g2maurer/MPPT1KW/README.md

# MPPT1KW
 Solar Battery Charger
   1. 4/18/2023 Added PCB files (KiCad).
   2. 10/11/2023 Updated BOM files:
      MPPT_1KW_ESP32_ggmV3.xlsx
      MPPT V3 BOM.pdf
   4. 04/23/2024 Added new enclosure design (new design was done with FreeCAD).
      The dimensions have not changed but the new design incorporates the fan and vent grills.
