g2maurer/MPPT1KW/Enclosure/FreeCAD/MPPT Cover.FCStd

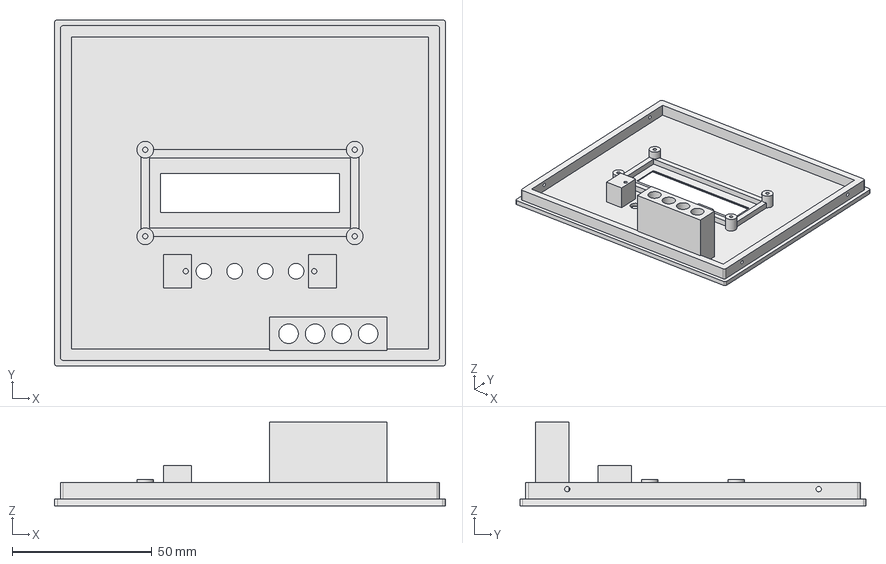
[picture p1: CAD file, 2024-04-24]
Enclosure/FreeCAD/MPPT Cover.FCStd
140.0 x 124.0 x 30.0 mm
