g2maurer/MPPT1KW/Enclosure/TinkerCAD/Back_Grill_V2.stl

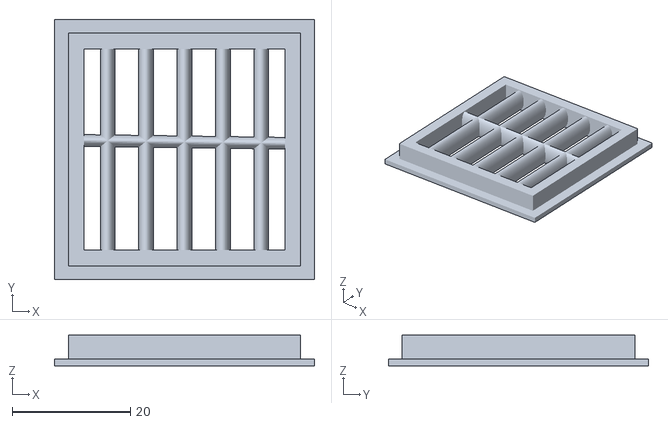
[picture p2: CAD file, 2024-04-18]
Enclosure/TinkerCAD/Back_Grill_V2.stl
44.0 x 44.0 x 5.20
