g2maurer/MPPT1KW/Enclosure/FreeCAD/MPPT_Button.FCStd

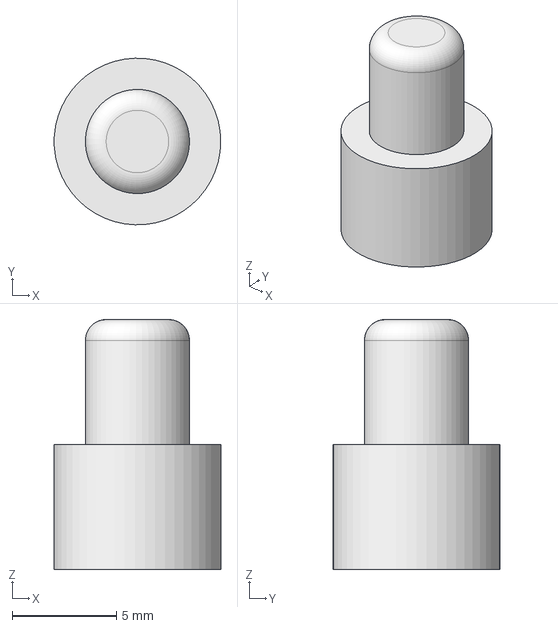
[picture p3: CAD file, 2024-04-24]
Enclosure/FreeCAD/MPPT_Button.FCStd
7.99 x 8.00 x 12.0 mm
