g2maurer/MPPT1KW/Enclosure/TinkerCAD/MPPT_g2m_V3.1.stl

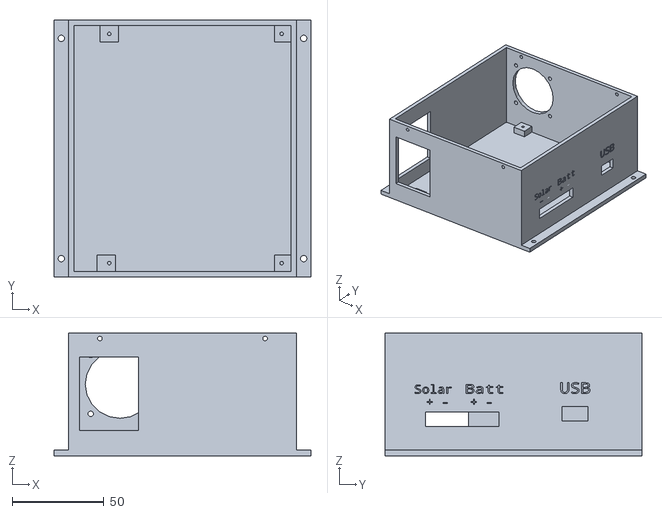
[picture p4: CAD file, 2024-04-18]
Enclosure/TinkerCAD/MPPT_g2m_V3.1.stl
140.0 x 140.0 x 67.0
