g2maurer/MPPT1KW/Enclosure/FreeCAD/MPPT Enclosure.stl

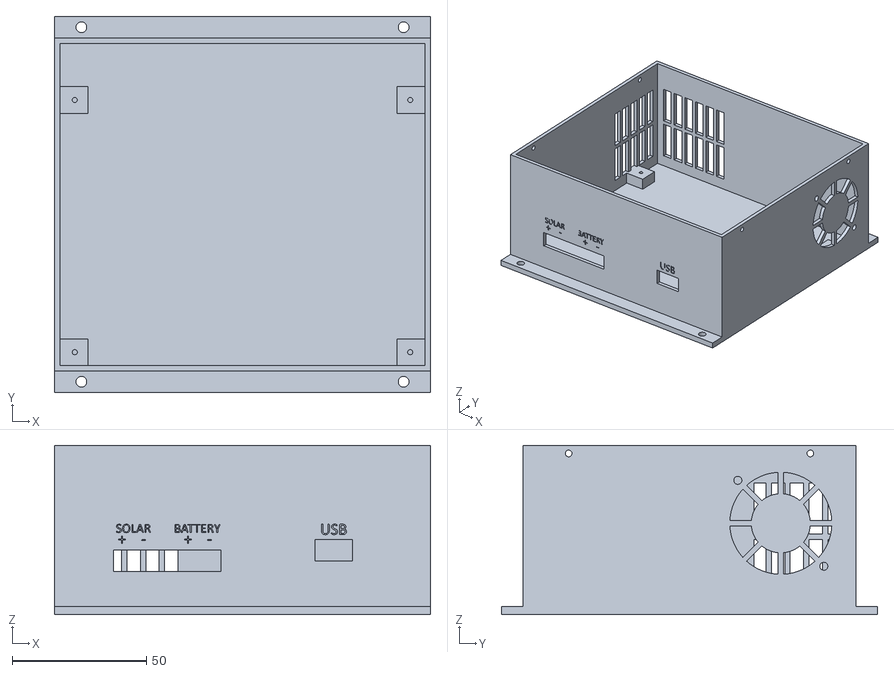
[picture p5: CAD file, 2024-04-23]
Enclosure/FreeCAD/MPPT Enclosure.stl
140.0 x 140.0 x 63.0
