g2maurer/MPPT1KW/Enclosure/TinkerCAD/Side_Grill_V2.stl

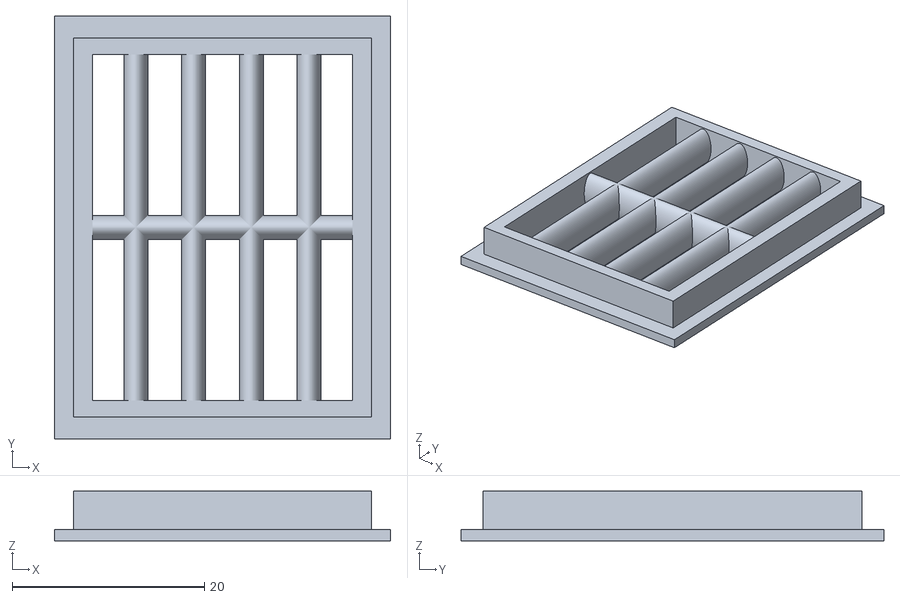
[picture p6: CAD file, 2024-04-18]
Enclosure/TinkerCAD/Side_Grill_V2.stl
35.0 x 44.0 x 5.20
