g2maurer/MPPT1KW/Enclosure/TinkerCAD/Fan Cover 40mm.stl

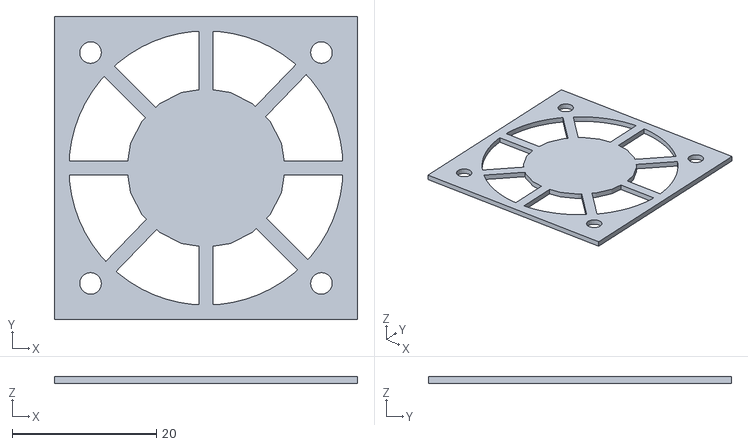
[picture p7: CAD file, 2024-04-18]
Enclosure/TinkerCAD/Fan Cover 40mm.stl
42.0 x 42.0 x 1.00
