g2maurer/MPPT1KW/(list of files, cad)

Other CAD files:
Enclosure/FreeCAD/MPPT Button.stl
Enclosure/FreeCAD/MPPT Cover.stl
