g2maurer/MPPT1KW/PCB/MPPT_1KW_ESP32_ggmV3.kicad_pcb

## KiCad design PCB/MPPT_1KW_ESP32_ggmV3.kicad_pcb (2023-04-18)

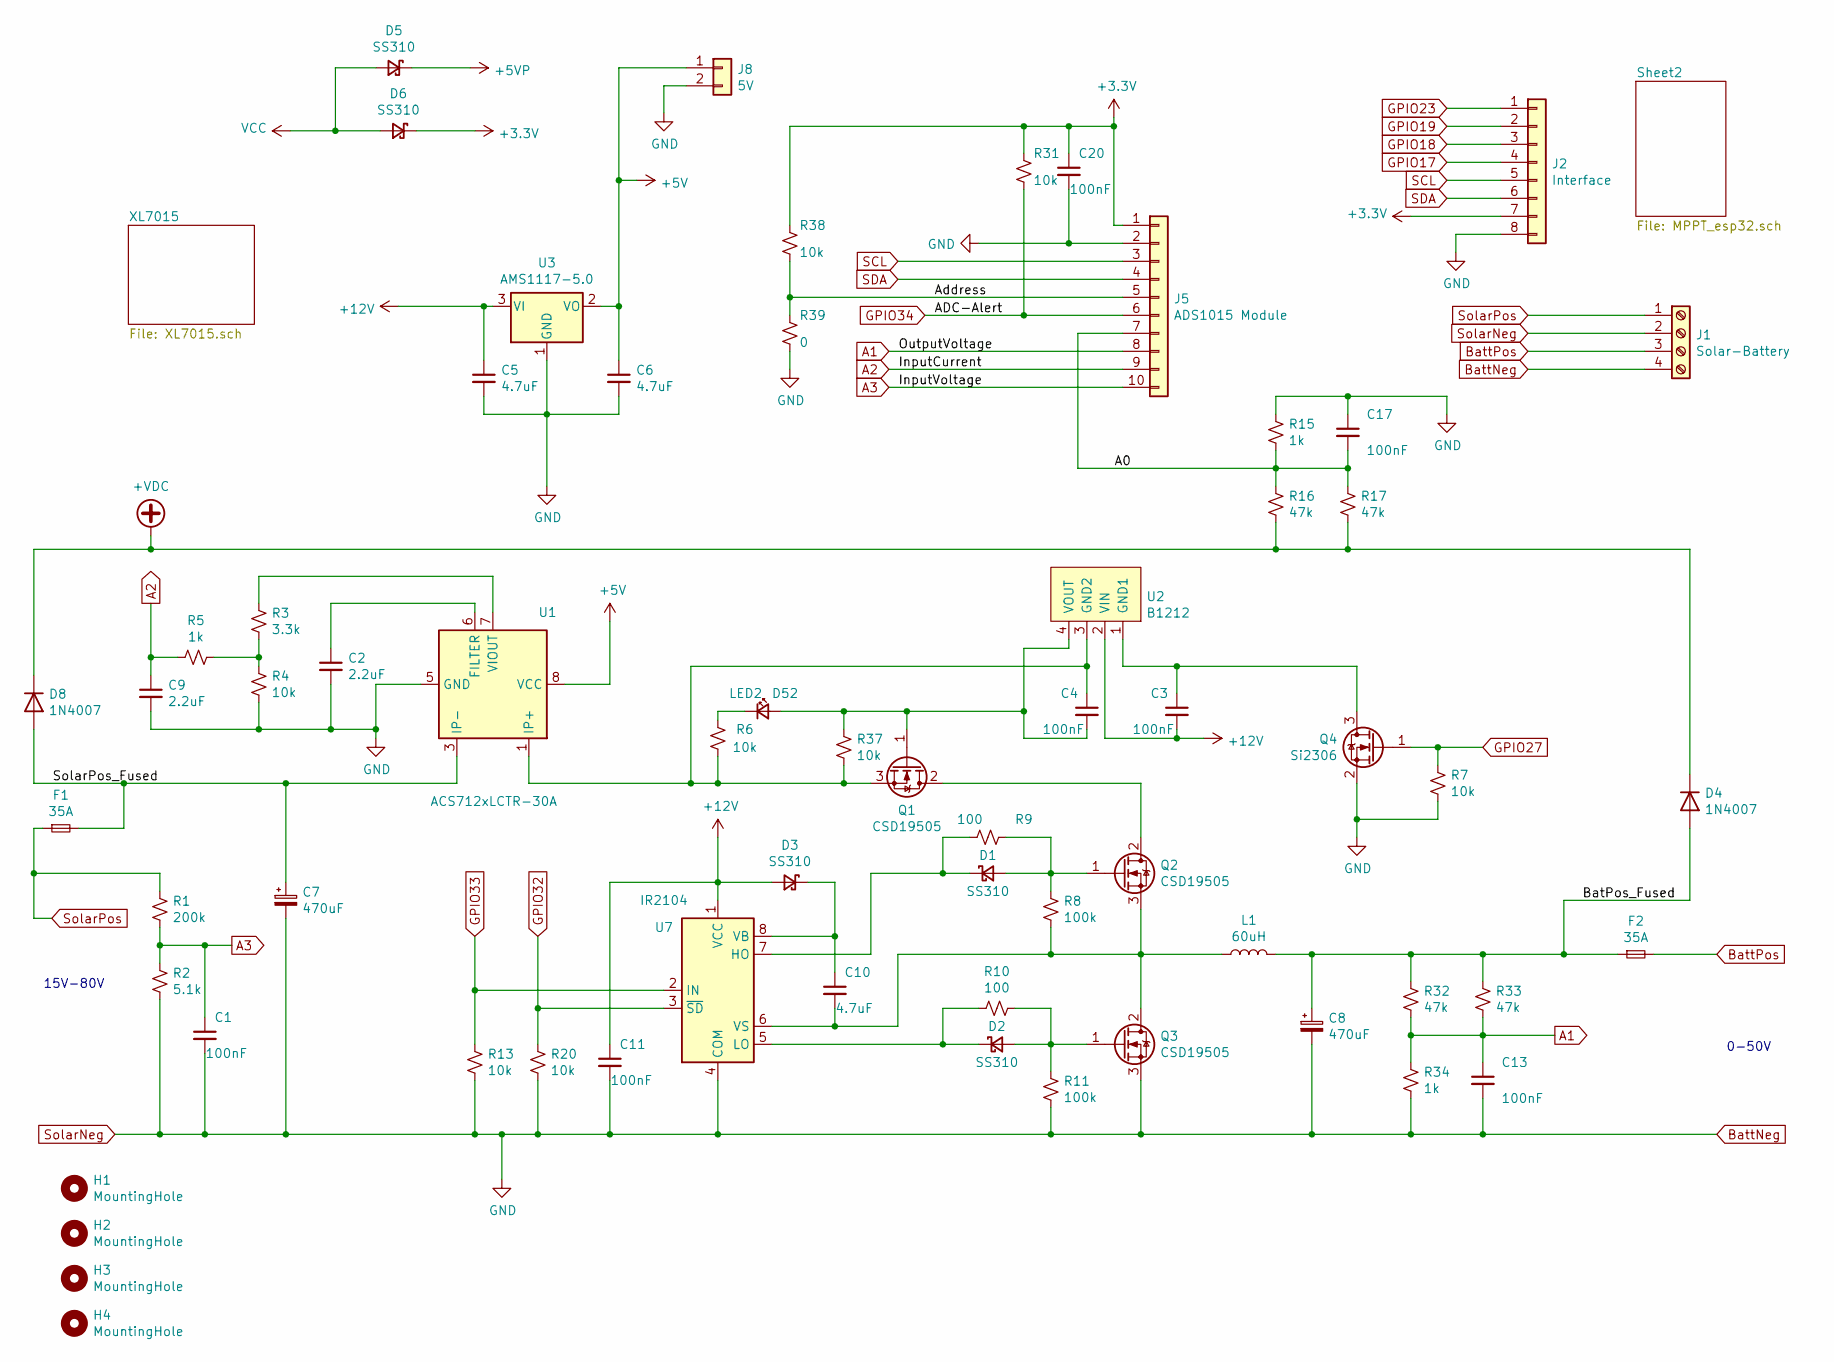
[picture p11: schematic MPPT_1KW_ESP32_ggmV3.sch, MPPT V3]

Parts:
C1, C3, C4, C11, C13, C17, C20: 100nF; C_0805_2012Metric_Pad1.18x1.45mm_HandSolder
C2, C9: 2.2uF; C_0805_2012Metric_Pad1.18x1.45mm_HandSolder
C5, C6, C10: 4.7uF; C_1206_3216Metric_Pad1.33x1.80mm_HandSolder
C7, C8: 470uF; CP_Radial_D16.0mm_P7.50mm
D1, D2, D3, D5, D6: SS310; D_2010_5025Metric_Pad1.52x2.65mm_HandSolder
D4, D8: 1N4007; D_2010_5025Metric_Pad1.52x2.65mm_HandSolder
D52: LED2; LED_0805_2012Metric_Pad1.15x1.40mm_HandSolder
F1, F2: 35A; Mini_Blade
H1, H2, H3, H4: MountingHole; MountingHole_2.7mm
J1: Solar-Battery; Conn-Screw-4-term
J2: Interface; JST_XH_B8B-XH-A_1x08_P2.50mm_Vertical
J5: ADS1015 Module; JST_XH_B10B-XH-A_1x10_P2.50mm_Vertical
J8: 5V; JST_XH_B2B-XH-A_1x02_P2.50mm_Vertical
L1: 60uH; L_Toroid_Vertical_L41.9mm_W17.8mm_P12.70mm_Pulse_F
Q1, Q2, Q3: CSD19505; TO-220-3_Vertical
Q4: Si2306; SOT-23
R1: 200k; R_0805_2012Metric_Pad1.20x1.40mm_HandSolder
R2: 5.1k; R_0805_2012Metric_Pad1.20x1.40mm_HandSolder
R3: 3.3k; R_0805_2012Metric_Pad1.20x1.40mm_HandSolder
R4, R6, R7, R13, R20, R31, R37, R38: 10k; R_0805_2012Metric_Pad1.20x1.40mm_HandSolder
R5, R15, R34: 1k; R_0805_2012Metric_Pad1.20x1.40mm_HandSolder
R8, R11: 100k; R_0805_2012Metric_Pad1.20x1.40mm_HandSolder
R9, R10: 100; R_0805_2012Metric_Pad1.20x1.40mm_HandSolder
R16, R17, R32, R33: 47k; R_0805_2012Metric_Pad1.20x1.40mm_HandSolder
R39: 0; R_0805_2012Metric_Pad1.20x1.40mm_HandSolder
U1: ACS712xLCTR-30A; SOIC-8_3.9x4.9mm_P1.27mm
U2: B1212; B1212S
U3: AMS1117-5.0; SOT-223-3_TabPin2
U7: IR2104; SOIC-8_3.9x4.9mm_P1.27mm

Connections:
+3V3: C20.1, D6.1 (K), J2.7, J5.1, R31.1, R38.1; also elsewhere on the board
+5V: C6.1, J8.1, U1.8 (VCC), U3.2 (VO)
+5VP: D5.1 (K); also elsewhere on the board
+12V: C3.2, C5.1, C11.1, D3.2 (A), U2.2 (VIN), U3.3 (VI), U7.1 (VCC); also elsewhere on the board
+VDC: D4.1 (K), D8.1 (K), R16.2, R17.2; also elsewhere on the board
/A0: C17.2, J5.7, R15.2, R16.1, R17.1
/Address: J5.5, R38.2, R39.1
/BatPos_Fused: C8.1, D4.2 (A), F2.1, L1.2, R32.1, R33.1
/SolarPos_Fused: C7.1, D8.2 (A), F1.2, U1.3 (IP-), U1.4 (IP-)
A1: C13.1, J5.8, R32.2, R33.2, R34.1
A2: C9.1, J5.9, R5.2
A3: C1.1, J5.10, R1.2, R2.1
BattNeg: C1.2, C2.2, C5.2, C6.2, C7.2, C8.2, C9.2, C11.2, C13.2, C17.1, C20.2, J1.2, J1.4, J2.8, J5.2, J8.2, Q3.3 (S), Q4.2 (S), R2.2, R4.2, R7.2, R11.2, R13.2, R15.1, R20.2, R34.2, R39.2, U1.5 (GND), U3.1 (GND), U7.4 (COM); also elsewhere on the board
BattPos: F2.2, J1.3
GPIO17: J2.4; also elsewhere on the board
GPIO18: J2.3; also elsewhere on the board
GPIO19: J2.2; also elsewhere on the board
GPIO23: J2.1; also elsewhere on the board
GPIO27: Q4.1 (G), R7.1; also elsewhere on the board
GPIO32: R20.1, U7.3 (~SD); also elsewhere on the board
GPIO33: R13.1, U7.2 (IN); also elsewhere on the board
GPIO34: J5.6, R31.2; also elsewhere on the board
unnamed: C2.1, U1.6 (FILTER)
unnamed: C3.1, Q4.3 (D), U2.1 (GND1)
unnamed: C4.1, Q1.3 (S), R6.1, R37.2, U1.1 (IP+), U1.2 (IP+), U2.3 (GND2)
unnamed: C4.2, D52.2 (A), Q1.1 (G), R37.1, U2.4 (VOUT)
unnamed: C10.1, D3.1 (K), U7.8 (VB)
unnamed: C10.2, L1.1, Q2.3 (S), Q3.2 (D), R8.2, U7.6 (VS)
unnamed: D1.1 (K), R9.2, U7.7 (HO)
unnamed: D1.2 (A), Q2.1 (G), R8.1, R9.1
unnamed: D2.1 (K), R10.2, U7.5 (LO)
unnamed: D2.2 (A), Q3.1 (G), R10.1, R11.1
unnamed: D52.1 (K), R6.2
unnamed: Q1.2 (D), Q2.2 (D)
unnamed: R3.1, U1.7 (VIOUT)
unnamed: R3.2, R4.1, R5.1
SCL: J2.5, J5.3; also elsewhere on the board
SDA: J2.6, J5.4; also elsewhere on the board
SolarPos: F1.1, J1.1, R1.1
VCC: D5.2 (A), D6.2 (A); also elsewhere on the board

Notes on the sheet:
15V-80V
0-50V

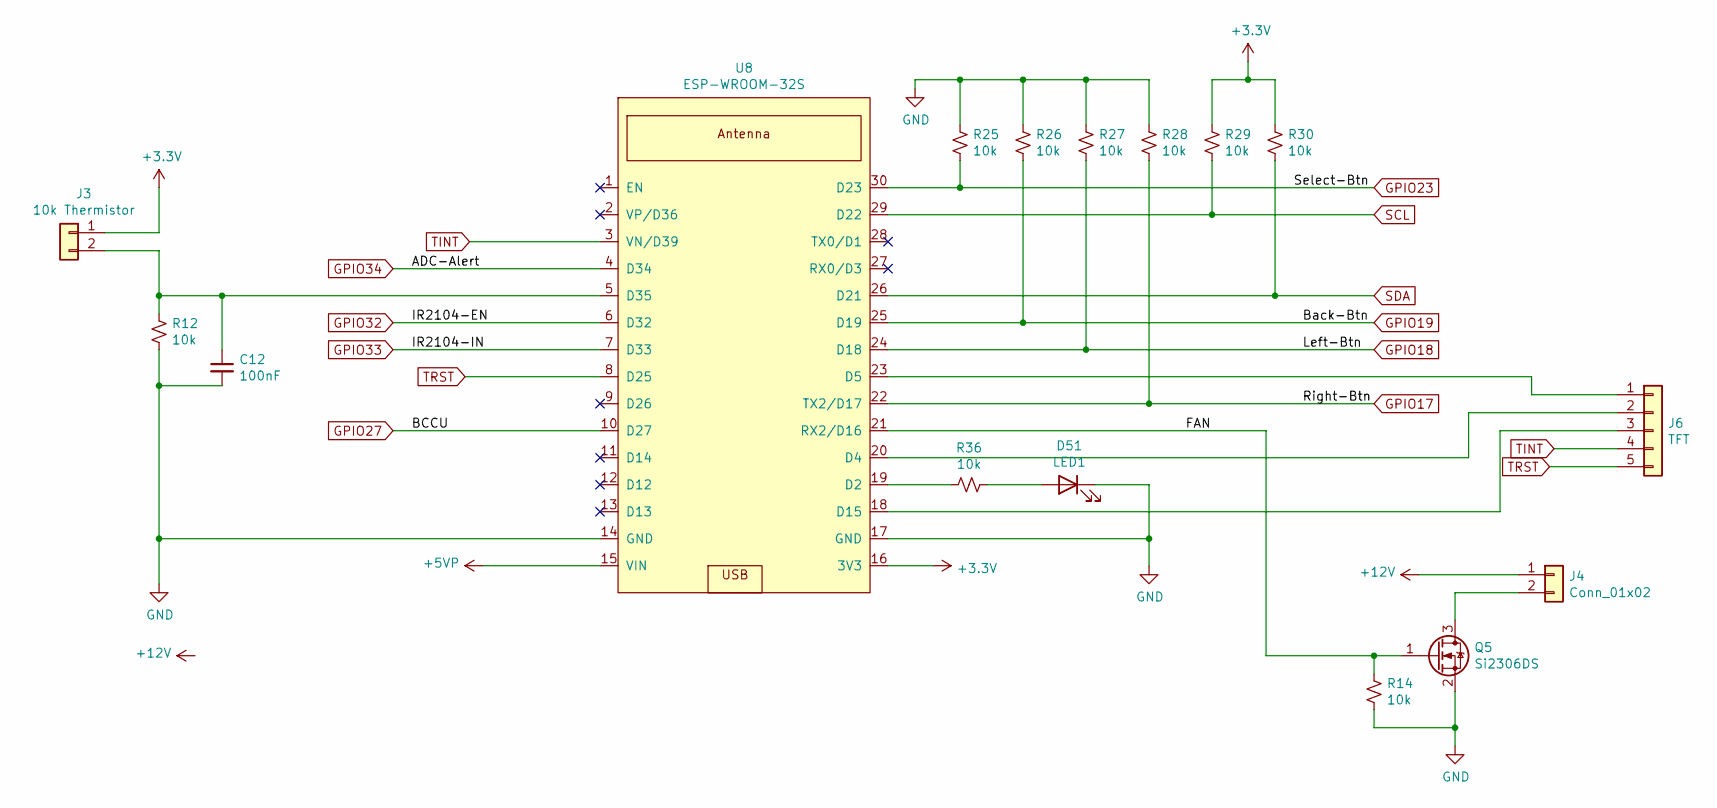
[picture p12: schematic MPPT_esp32.sch, MPPT V3]

Parts:
C12: 100nF; C_0805_2012Metric_Pad1.18x1.45mm_HandSolder
D51: LED1; LED_0805_2012Metric_Pad1.15x1.40mm_HandSolder
J3: 10k Thermistor; JST_XH_B2B-XH-A_1x02_P2.50mm_Vertical
J4: Conn_01x02; JST_XH_B2B-XH-A_1x02_P2.50mm_Vertical
J6: TFT; JST_XH_B5B-XH-A_1x05_P2.50mm_Vertical
Q5: Si2306DS; SOT-23
R12, R14, R25, R26, R27, R28, R29, R30, R36: 10k; R_0805_2012Metric_Pad1.20x1.40mm_HandSolder
U8: ESP-WROOM-32S

Connections:
+3V3: J3.1, R29.1, R30.1, U8.16 (3V3); also elsewhere on the board
+5VP: U8.15 (VIN); also elsewhere on the board
+12V: J4.1; also elsewhere on the board
/Sheet2/FAN: Q5.1 (G), R14.1, U8.21 (RX2/D16)
BattNeg: C12.2, D51.1 (K), Q5.2 (S), R12.2, R14.2, R25.1, R26.1, R27.1, R28.1, U8.14 (GND), U8.17 (GND); also elsewhere on the board
GPIO17: R28.2, U8.22 (TX2/D17); also elsewhere on the board
GPIO18: R27.2, U8.24 (D18); also elsewhere on the board
GPIO19: R26.2, U8.25 (D19); also elsewhere on the board
GPIO23: R25.2, U8.30 (D23); also elsewhere on the board
GPIO27: U8.10 (D27); also elsewhere on the board
GPIO32: U8.6 (D32); also elsewhere on the board
GPIO33: U8.7 (D33); also elsewhere on the board
GPIO34: U8.4 (D34); also elsewhere on the board
unnamed: C12.1, J3.2, R12.1, U8.5 (D35)
unnamed: D51.2 (A), R36.1
unnamed: J4.2, Q5.3 (D)
unnamed: J6.1, U8.23 (D5)
unnamed: J6.2, U8.20 (D4)
unnamed: J6.3, U8.18 (D15)
unnamed: R36.2, U8.19 (D2)
SCL: R29.2, U8.29 (D22); also elsewhere on the board
SDA: R30.2, U8.26 (D21); also elsewhere on the board
TINT: J6.4, U8.3 (VN/D39)
TRST: J6.5, U8.8 (D25)

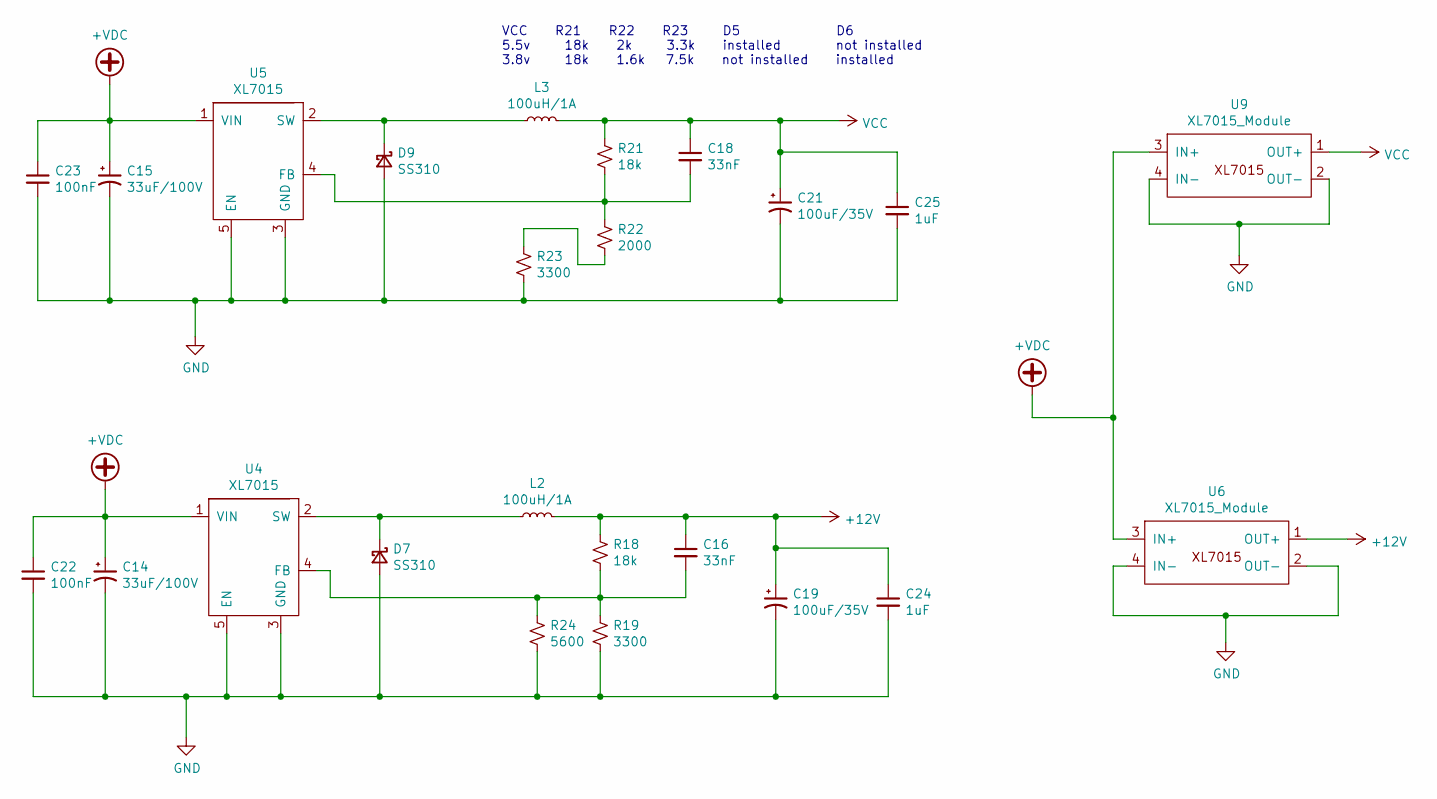
[picture p13: schematic XL7015.sch, MPPT V3]

Parts:
C14, C15: 33uF/100V; CP_Radial_D8.0mm_P2.50mm
C16, C18: 33nF; C_0805_2012Metric_Pad1.18x1.45mm_HandSolder
C19, C21: 100uF/35V; CP_Radial_D6.3mm_P2.50mm
C22, C23: 100nF; C_0805_2012Metric_Pad1.18x1.45mm_HandSolder
C24, C25: 1uF; C_0805_2012Metric_Pad1.18x1.45mm_HandSolder
D7, D9: SS310; D_2010_5025Metric_Pad1.52x2.65mm_HandSolder
L2, L3: 100uH/1A; L_Taiyo-Yuden_NR-60xx_HandSoldering
R18, R21: 18k; R_0805_2012Metric_Pad1.20x1.40mm_HandSolder
R19, R23: 3300; R_0805_2012Metric_Pad1.20x1.40mm_HandSolder
R22: 2000; R_0805_2012Metric_Pad1.20x1.40mm_HandSolder
R24: 5600; R_0805_2012Metric_Pad1.20x1.40mm_HandSolder
U4, U5: XL7015; TO-252-5_TabPin3
U6, U9: XL7015_Module; Module_XL7015

Connections:
+12V: C16.1, C19.1, C24.1, L2.2, R18.1, U6.1 (OUT+); also elsewhere on the board
+VDC: C14.1, C15.1, C22.1, C23.1, U4.1 (VIN), U5.1 (VIN), U6.3 (IN+), U9.3 (IN+); also elsewhere on the board
BattNeg: C14.2, C15.2, C19.2, C21.2, C22.2, C23.2, C24.2, C25.2, D7.2 (A), D9.2 (A), R19.2, R23.2, R24.2, U4.3 (GND), U4.5 (EN), U5.3 (GND), U5.5 (EN), U6.2 (OUT-), U6.4 (IN-), U9.2 (OUT-), U9.4 (IN-); also elsewhere on the board
unnamed: C16.2, R18.2, R19.1, R24.1, U4.4 (FB)
unnamed: C18.2, R21.2, R22.1, U5.4 (FB)
unnamed: D7.1 (K), L2.1, U4.2 (SW)
unnamed: D9.1 (K), L3.1, U5.2 (SW)
unnamed: R22.2, R23.1
VCC: C18.1, C21.1, C25.1, L3.2, R21.1, U9.1 (OUT+); also elsewhere on the board

Notes on the sheet:
VCC R21 R22 R23 D5 D6 5.5v 18k 2k 3.3k installed not installed 3.8v 18k 1.6k 7.5k not installed installed

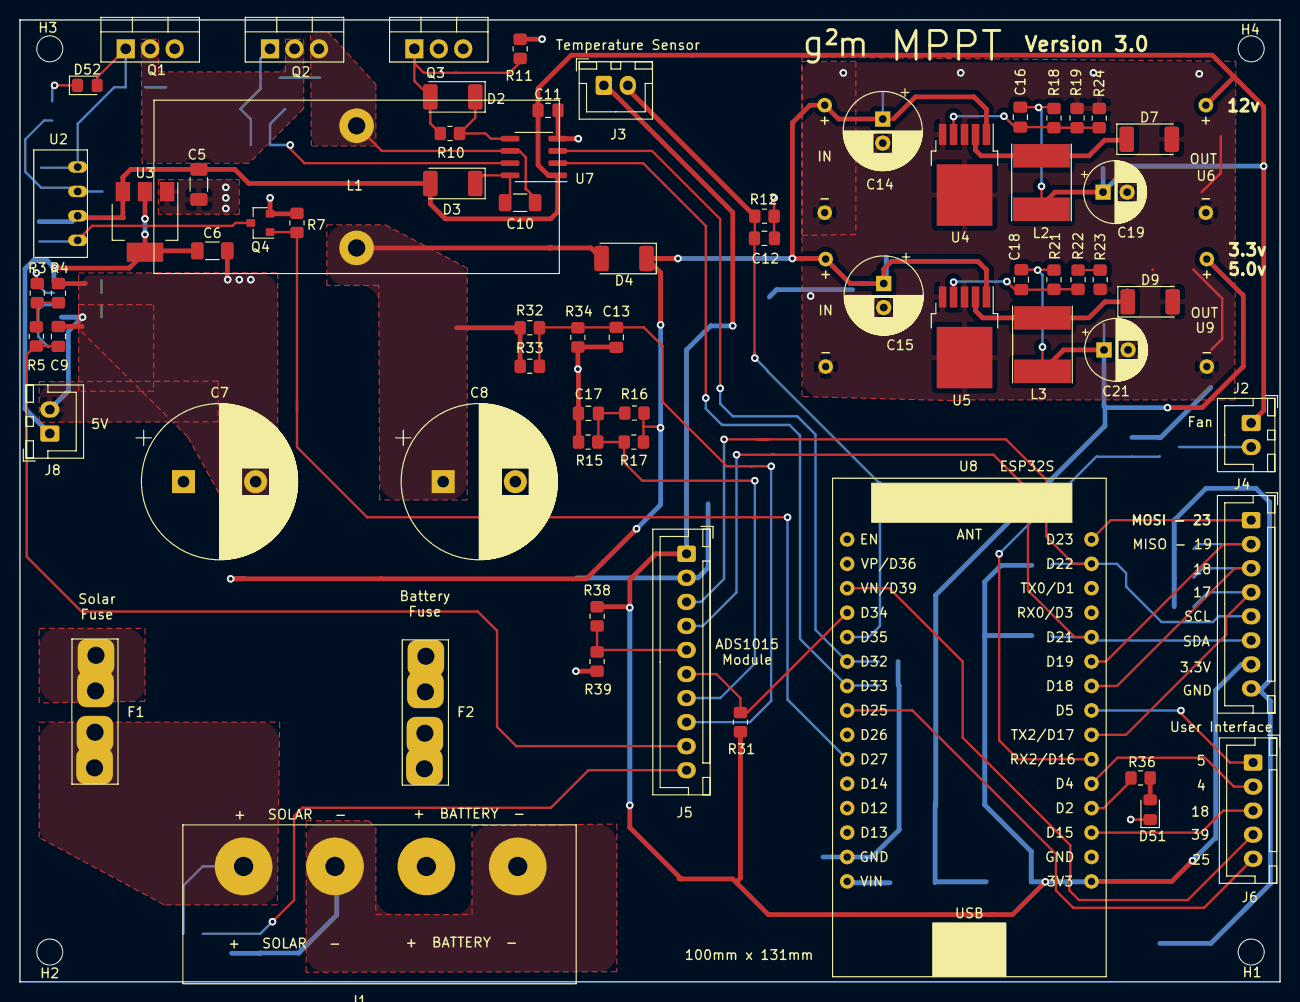
[picture p14: board MPPT_1KW_ESP32_ggmV3.kicad_pcb from above]

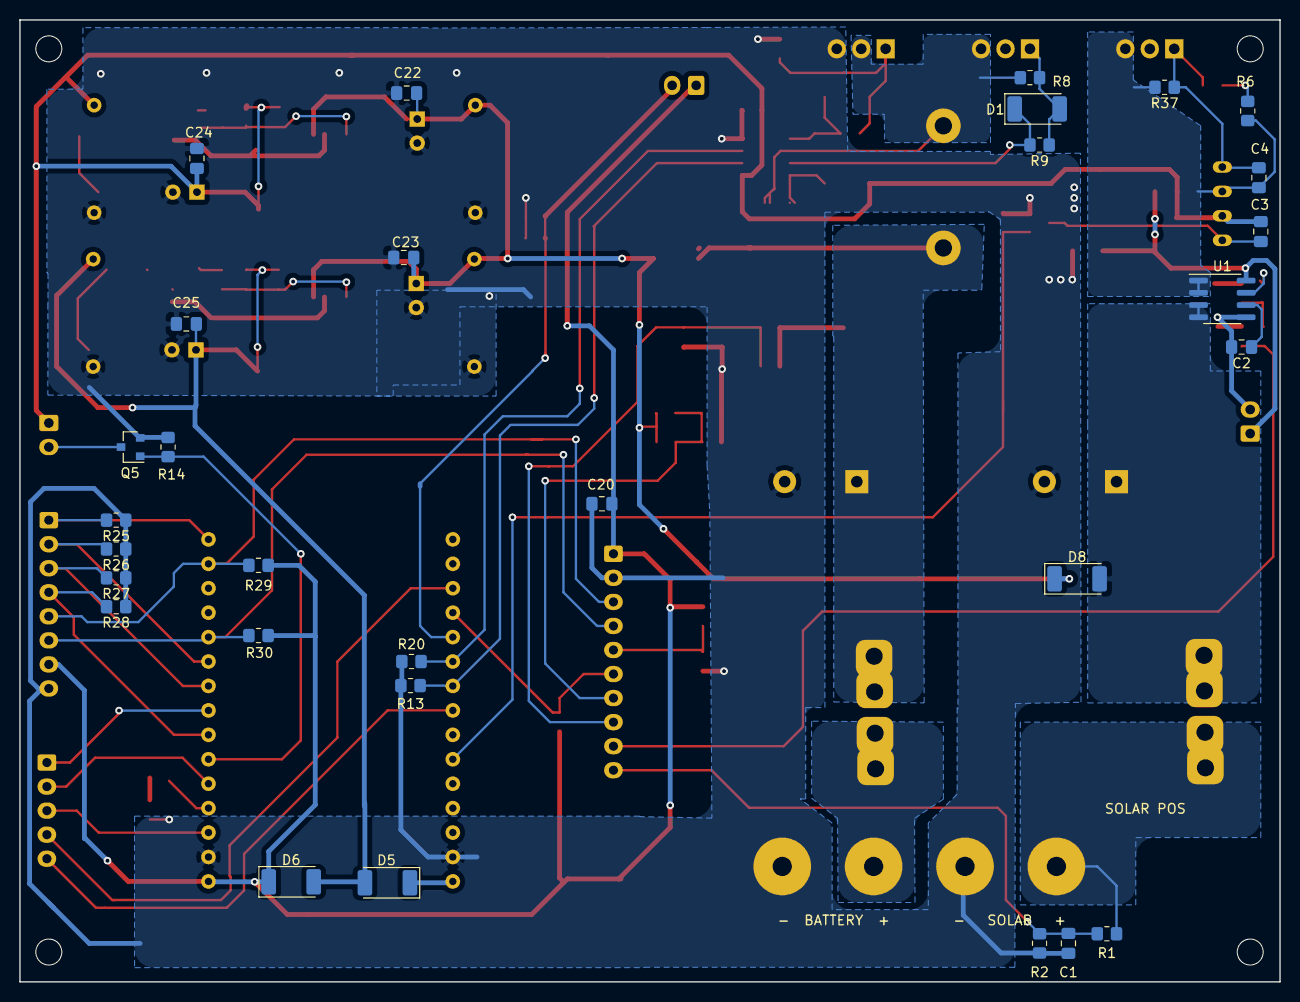
[picture p15: board MPPT_1KW_ESP32_ggmV3.kicad_pcb from below]

Board: 2 copper layers, 131.0 x 100.0 mm, 104 parts (30 on the bottom side), 55 nets.
