g2maurer/MPPT1KW/(commit log)

2023-04-18 Initial post
    [MPPT_1KW_ESP32_ggmV3-B_Cu.gbr, MPPT_1KW_ESP32_ggmV3-B_Mask.gbr, MPPT_1KW_ESP32_ggmV3-B_Paste.gbr, MPPT_1KW_ESP32_ggmV3-B_SilkS.gbr, MPPT_1KW_ESP32_ggmV3-Edge_Cuts.gbr, MPPT_1KW_ESP32_ggmV3-F_Cu.gbr, MPPT_1KW_ESP32_ggmV3-F_Mask.gbr, MPPT_1KW_ESP32_ggmV3-F_Paste.gbr]
2023-04-18 Move to PCB folder
    [MPPT_1KW_ESP32_ggmV3-B_Cu.gbr, MPPT_1KW_ESP32_ggmV3-B_Mask.gbr, MPPT_1KW_ESP32_ggmV3-B_Paste.gbr, MPPT_1KW_ESP32_ggmV3-B_SilkS.gbr, MPPT_1KW_ESP32_ggmV3-Edge_Cuts.gbr, MPPT_1KW_ESP32_ggmV3-F_Cu.gbr, MPPT_1KW_ESP32_ggmV3-F_Mask.gbr, MPPT_1KW_ESP32_ggmV3-F_Paste.gbr]
2023-10-11 Updated BOM
    [MPPT_1KW_ESP32_ggmV3.xlsx]
2024-04-18 Added STL files to project.
    TinkerCAD STL files for enclosure.
    [Back_Grill_V2.stl, Fan Cover 40mm.stl, MPPT enclosure.xlsx, MPPT_g2m_V3.0.stl, MPPT_g2m_V3.1.stl, Side_Grill_V2.stl]
2024-04-23 Add new enclosure design
    Redesigned MPPT enclosure using FreeCAD.
    [MPPT-Body.stl]
2024-04-23 Replaced Enclosure STL File
    [MPPT Enclosure.stl, MPPT-Body.stl]
2024-04-24 Update STLs
    Update the STL generated from FreeCAD.
    [MPPT Button.stl, MPPT Cover.FCStd, MPPT Cover.stl, MPPT_Button.FCStd]
